IE-TDD-EL3313/Proyecto_2/gestion_entradas_reloj/README.md

# Gestión de entradas locales y reloj

Este bloque reemplaza los módulos provisionales `boton_pulso.sv` y
`clk_div_1s.sv` utilizados por el arnés de pruebas de la lógica del juego.

## Estructura

- `rtl/generador_ce.sv`: divisor parametrizable que genera un pulso de un ciclo.
- `rtl/reloj_integrado.sv`: genera `ce_debounce`, `ce_1s` y `ce_display`.
- `rtl/banco_sincronizadores.sv`: sincronizador de dos etapas para los botones.
- `rtl/filtro_antirrebote.sv`: exige muestras consecutivas antes de aceptar
  una transición.
- `rtl/banco_filtros_antirrebote.sv`: aplica el filtro a los tres botones.
- `rtl/detector_flanco_subida.sv`: genera un pulso al detectar una transición
  estable de 0 a 1.
- `rtl/banco_detectores_flanco.sv`: genera los pulsos de los tres botones.
- `rtl/gestion_entradas_locales.sv`: integra la cadena completa y entrega
  `sel_pulse`, `ok_pulse` y `rst_pulse`.
- `rtl/entradas_reloj.sv`: bloque superior que integra las entradas locales
  con las tres habilitaciones temporales.
- `tb/tb_reloj_integrado.sv`: prueba autoverificable del bloque de reloj.
- `tb/tb_banco_sincronizadores.sv`: prueba del banco de sincronizadores.
- `tb/tb_banco_filtros_antirrebote.sv`: prueba rebotes, pulsación, liberación
  e independencia entre canales.
- `tb/tb_banco_detectores_flanco.sv`: comprueba pulsos individuales,
  simultáneos y botones mantenidos.
- `tb/tb_gestion_entradas_locales.sv`: inyecta rebotes en los botones físicos
  y verifica la cadena completa.
- `tb/tb_entradas_reloj.sv`: verifica conjuntamente botones y reloj integrado.

El diseño utiliza exclusivamente el reloj principal `clk`; las salidas `ce_*`
son habilitaciones y no deben conectarse como relojes derivados.

La convención utilizada para los buses de botones es:

- `btn[0]`: `BTN_SEL`.
- `btn[1]`: `BTN_OK`.
- `btn[2]`: `BTN_RST`.

Con la configuración definitiva, el antirrebote toma 20 muestras a 1 kHz, por
lo que una transición debe permanecer estable durante 20 ms para ser aceptada.

## Señales de reinicio

`rst_n` es el reinicio activo en bajo de la electrónica del bloque.
`btn_rst_i` se procesa igual que los otros botones y produce `rst_pulse`, que
solicita a la lógica principal reiniciar el juego. No se debe obtener `rst_n`
directamente de `btn_rst_i`, porque eso impediría generar correctamente el
pulso filtrado de reinicio del juego.

## Prueba en Nexys 4

`pruebas_fpga/top/top_prueba_entradas_reloj.sv` y
`pruebas_fpga/constraints/entradas_reloj_nexys4.xdc` forman un arnés exclusivo
para la Nexys 4 Rev. B (`xc7a100ticsg324-1L`).

- BTNU cambia LED0 una vez por pulsación.
- BTNC cambia LED1 una vez por pulsación.
- BTND cambia LED2 una vez por pulsación.
- LED3 cambia automáticamente una vez por segundo.
- CPU_RESETN apaga los cuatro LED y reinicia la electrónica.

Para generar el bitstream desde una terminal:

```bash
vivado -mode batch -source gestion_entradas_reloj/pruebas_fpga/generar_bitstream.tcl
```

El resultado queda en
`gestion_entradas_reloj/pruebas_fpga/build/top_prueba_entradas_reloj.bit`.
La carpeta `build` se ignora en Git porque contiene archivos generados.
