IE-TDD-EL3313/Proyecto_2/docs/diseño/figuras/diagrama_nivel3_visualizacion_y_alerta.jpeg

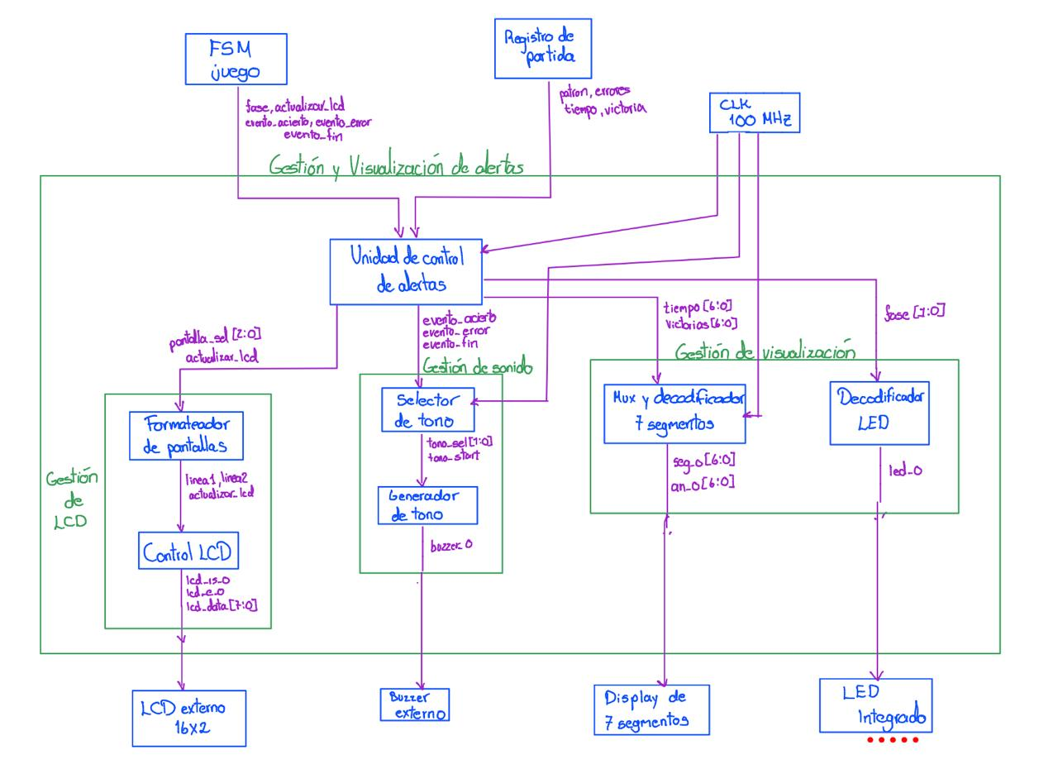
docs/diseño/figuras/diagrama_nivel3_visualizacion_y_alerta.jpeg
