IE-TDD-EL3313/Proyecto_2/(commit log)

2026-08-30 Creando el archivo de diseño
2026-09-04 Diagramas de primer y segundo nivel
2026-09-04 Se agregan secciones al doc. de diseño
    Added detailed descriptions for various sub-blocks related to game control, timing management, and word management in the design document.
2026-09-04 Diagrama de tercer nivel
2026-09-04 Agregando diagrama de tercer nivel
2026-09-08 diagrama unidad de gestion de visualizacion y alertas
2026-09-09 Agrega archivos de pruebas de FPGA y documentacion principal
2026-09-10 Agrega generador de habilitaciones temporales
2026-09-10 Agrega banco de sincronizadores de botones
2026-09-10 Agrega banco de filtros antirrebote
2026-09-10 Integra el manejo de los tres botones
2026-09-10 Une el reloj con el manejo de botones
2026-09-14 se agrega testbenches del modulo de visualizacion y alerta
2026-09-15 Agrega una prueba para la Nexys 4
2026-09-15 Integra los botones y el reloj con el juego
2026-09-15 Fija AMOR en la prueba de la FPGA
2026-09-15 Adapta la recepcion UART a la Nexys 4
2026-09-15 Agrega prueba del receptor UART en la Nexys 4
2026-09-15 Adaptando el transmisor UART a la Nexys 4
2026-09-15 Probando el transmisor UART en la Nexys 4
2026-09-15 Uniendo la recepcion y transmision UART
2026-09-15 Recibiendo las letras del juego por UART
2026-09-15 Organizando los datos de la UART en registros
2026-09-15 Controlando el inicio y final de la UART
2026-09-15 Integrando el periferico UART completo
2026-09-15 Definiendo los mensajes enviados por UART
2026-09-15 Formando el patron de la palabra para la PC
2026-09-15 Avisando por UART lo que ocurre en el juego
2026-09-15 Ordenando los mensajes UART del juego
2026-09-15 Conectando los mensajes UART con el juego
2026-09-17 Create carpeta figuras para el informe
2026-09-17 Create technical report template for Ahorcado project
    Se añade una plantilla para el reporte que sigue la rubrica para el proyecto del Ahorcado FPGA/PC, incluyendo secciones de objetivos, especificaciones, metodologia y resultados
2026-09-17 Update UART protocol documentation
    Document the UART application protocol for communication between FPGA and PC, including message structure and timing calculations.
2026-09-17 se agrega documentacion a informe tecnico en la seccion 3
    Updated technical report with corrections and additional details on UART and LCD peripherals, including signal descriptions, register maps, and electrical requirements.
2026-09-17 Actualizacion informe
    Se agregan secciones de introduccion, resumen, objetivos y especificaciones del proyecto
2026-09-17 Se actualiza seccion 7
    se actualizan subsecciones de la seccion 7
2026-09-17 Expand documentation on UART and LCD functionalities en seccion 4
    Added detailed explanation of UART protocol, including baud rate, bit structure, and reception process. Also included information on LCD control and multiplexing of seven-segment displays.
2026-09-17 Se completan las secciones 7.5 a 7.9
    Added detailed documentation for `uart_peripheral`, `uart_game_interface`, `lcd_peripheral`, `lcd_screen_controller`, and `io_controller` modules, including their functionalities, inputs/outputs, and state diagrams.
2026-09-17 correcion ruta de imagenes y se completa la sección 8
    Updated image paths and fixed formatting in the technical report.
2026-09-18 Actualizacion diagramas cuarto nivel visualizacion
    Added section on display and sound management, including details on alert control unit, LCD management, sound buzzer, seven-segment displays, and integrated LED.
2026-09-18 diagramas de cuarto nivel bloque visualizaciono
2026-09-18 arreglo de errores pequeños
2026-09-18 Agregando evidencias de simulacion e implementacion
2026-09-18 Explicacion corta de cada tb
    Removed instructions regarding the final top and Vivado setup.
